olokevin/Infrared_Target/InfraredRayTarget/InfraredRayTarget/InfraredRayTarget/Images/smallArmor.png

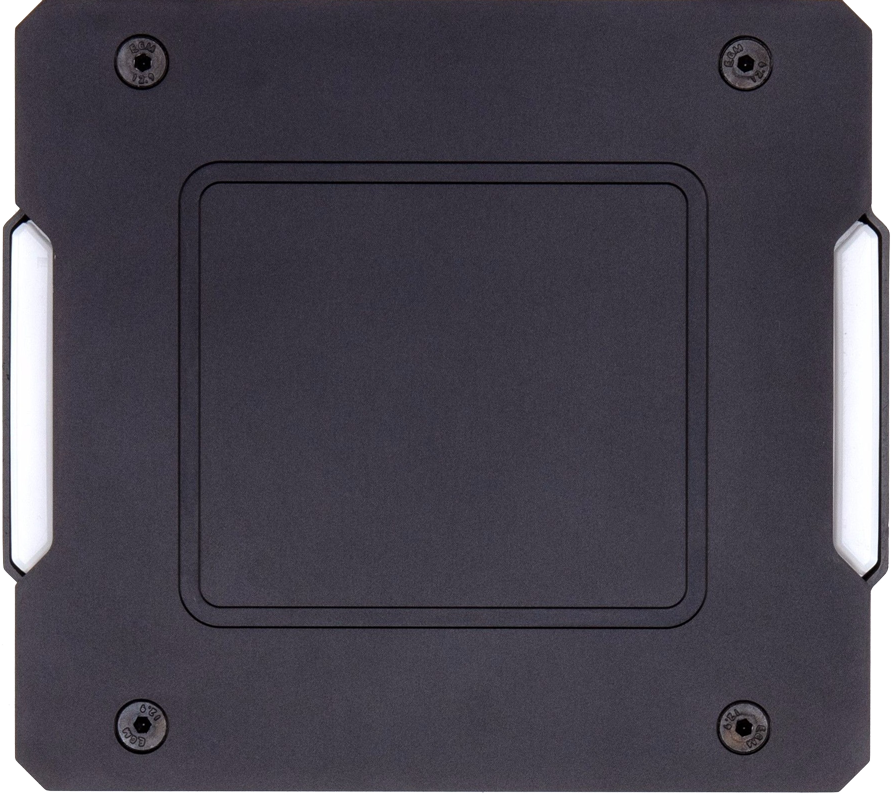
InfraredRayTarget/InfraredRayTarget/InfraredRayTarget/Images/smallArmor.png
