olokevin/Infrared_Target/InfraredRayTarget/InfraredRayTarget/InfraredRayTarget/bin/红外靶1.1/RM红外靶截图/123000.png

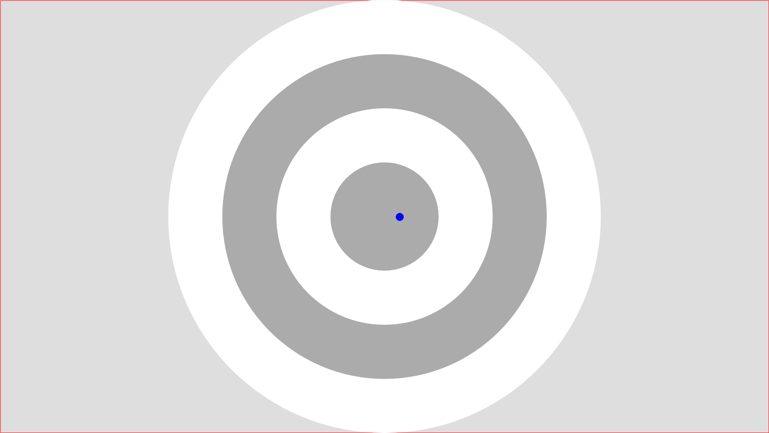
InfraredRayTarget/InfraredRayTarget/InfraredRayTarget/bin/红外靶1.1/RM红外靶截图/123000.png
