olokevin/Infrared_Target/InfraredRayTarget/InfraredRayTarget/InfraredRayTarget/bin/红外靶1.1/RM红外靶截图/player0 2019年09月12日 14时36分53秒.png

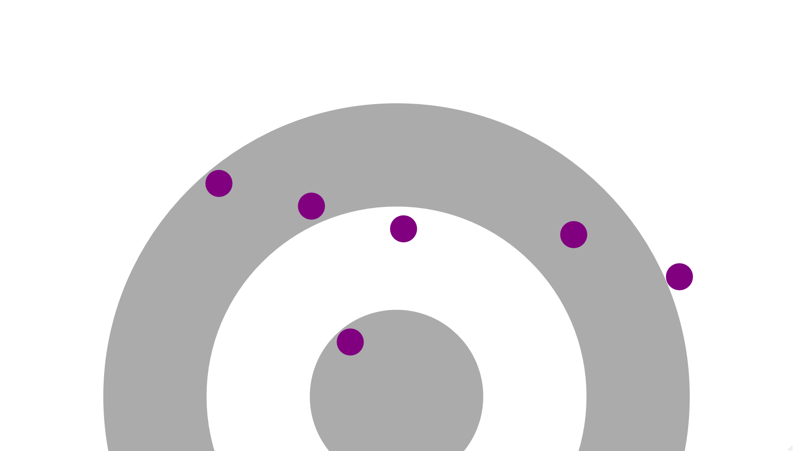
InfraredRayTarget/InfraredRayTarget/InfraredRayTarget/bin/红外靶1.1/RM红外靶截图/player0 2019年09月12日 14时36分53秒.png
