olokevin/Infrared_Target/InfraredRayTarget/InfraredRayTarget/InfraredRayTarget/bin/红外靶1.1/RM红外靶截图/player1弹道数据 2019年09月16日 15时26分09秒 2019年09月16日 15时35分35秒.png

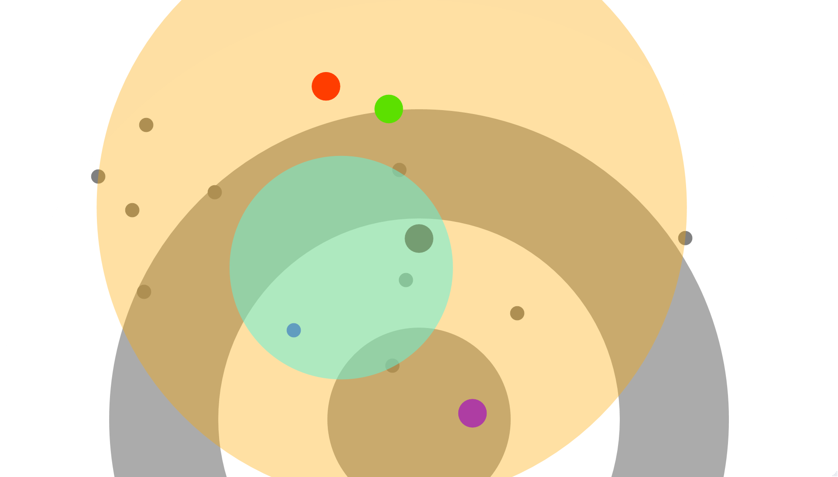
InfraredRayTarget/InfraredRayTarget/InfraredRayTarget/bin/红外靶1.1/RM红外靶截图/player1弹道数据 2019年09月16日 15时26分09秒 2019年09月16日 15时35分35秒.png
