olokevin/Infrared_Target/InfraredRayTarget/InfraredRayTarget/InfraredRayTarget/bin/红外靶1.1/RM红外靶截图/Temp 2019年09月27日 19时30分14秒.png

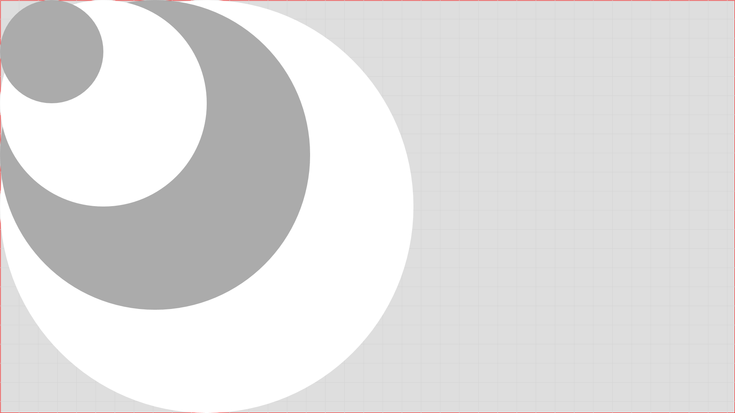
InfraredRayTarget/InfraredRayTarget/InfraredRayTarget/bin/红外靶1.1/RM红外靶截图/Temp 2019年09月27日 19时30分14秒.png
