olokevin/Infrared_Target/InfraredRayTarget/InfraredRayTarget/InfraredRayTarget/bin/红外靶1.1/RM红外靶截图/Temp弹道数据 2019年09月18日 16时16分26秒 2019年09月18日 16时19分42秒.png

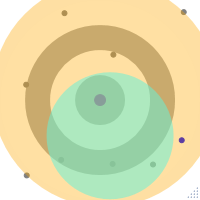
InfraredRayTarget/InfraredRayTarget/InfraredRayTarget/bin/红外靶1.1/RM红外靶截图/Temp弹道数据 2019年09月18日 16时16分26秒 2019年09月18日 16时19分42秒.png
