olokevin/Infrared_Target/InfraredRayTarget/InfraredRayTarget/InfraredRayTarget/bin/红外靶1.1/RM红外靶截图/Temp弹道数据 2019年11月07日 22时32分00秒 2019年11月07日 22时45分12秒.png

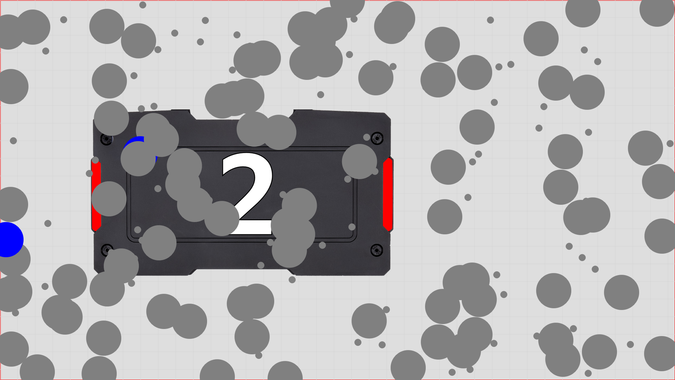
InfraredRayTarget/InfraredRayTarget/InfraredRayTarget/bin/红外靶1.1/RM红外靶截图/Temp弹道数据 2019年11月07日 22时32分00秒 2019年11月07日 22时45分12秒.png
