olokevin/Infrared_Target/InfraredRayTarget/InfraredRayTarget/InfraredRayTarget/Images/001x.png

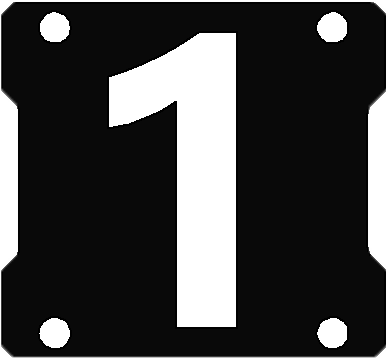
InfraredRayTarget/InfraredRayTarget/InfraredRayTarget/Images/001x.png
