olokevin/Infrared_Target/InfraredRayTarget/InfraredRayTarget/InfraredRayTarget/Images/002x.png

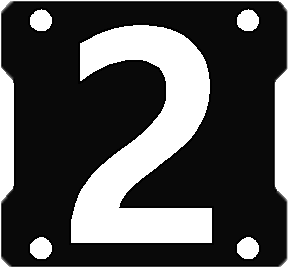
InfraredRayTarget/InfraredRayTarget/InfraredRayTarget/Images/002x.png
