olokevin/Infrared_Target/InfraredRayTarget/InfraredRayTarget/InfraredRayTarget/Images/bigArmor.png

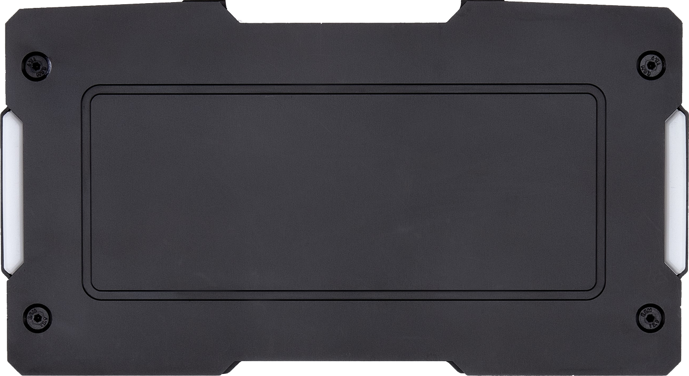
InfraredRayTarget/InfraredRayTarget/InfraredRayTarget/Images/bigArmor.png
