olokevin/Infrared_Target/InfraredRayTarget/InfraredRayTarget/InfraredRayTarget/Images/smal_armor.png

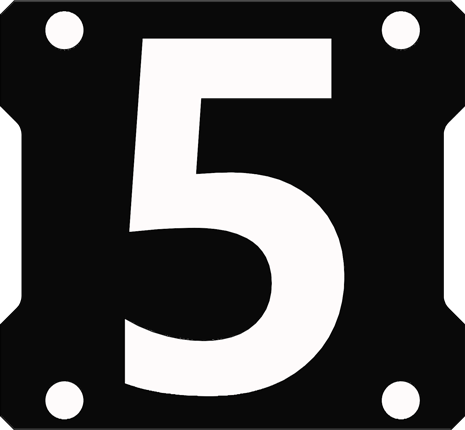
InfraredRayTarget/InfraredRayTarget/InfraredRayTarget/Images/smal_armor.png
