olokevin/Infrared_Target/InfraredRayTarget/InfraredRayTarget/InfraredRayTarget/Images/tempBlueArmor.png

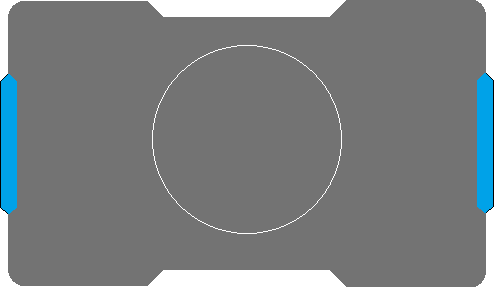
InfraredRayTarget/InfraredRayTarget/InfraredRayTarget/Images/tempBlueArmor.png
