olokevin/Infrared_Target/InfraredRayTarget/InfraredRayTarget/InfraredRayTarget/Images/tempRedArmor.png

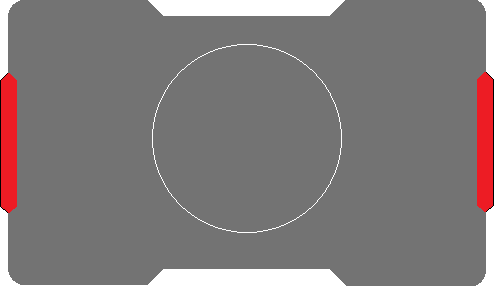
InfraredRayTarget/InfraredRayTarget/InfraredRayTarget/Images/tempRedArmor.png
