olokevin/Infrared_Target/红外靶工程图/红外靶开源资料/红外靶相关文档/红外靶说明简介.jpg

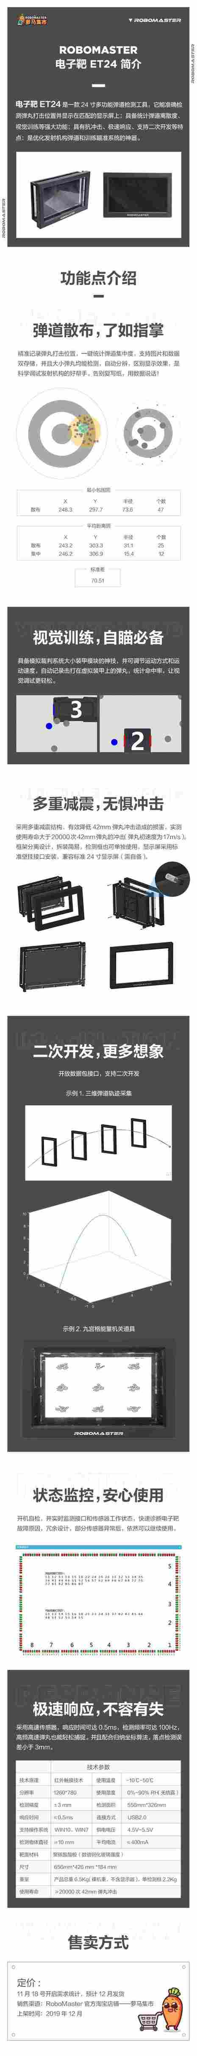
红外靶工程图/红外靶开源资料/红外靶相关文档/红外靶说明简介.jpg
