olokevin/Infrared_Target/红外靶工程图/红外靶开源资料/红外靶工程图及BOM清单/红外靶BOM表.xlsx

Sheet: 机械结构清单bom
序号 | 类别 | 名称 | 模块 | 料号 | 采购数量 | 单套数量 | 总数量 | 单价CNY | 单套总价 | 总价 | 库存 | 预计到货时间
 | 机加 | 钣金壳01 | 红外框 | banjinke01 | 2
 | 机加 | 钣金壳02 | 红外框 | banjinke02 | 1
 | 机加 | 钣金壳03 | 红外框 | banjinke03 | 1
 | 机加 | 铝架01 | 红外框 | 包含pipe 3/8 | 1
 | 机加 | 线材固定板 | 红外框 |  | 1
 | 机加 | 包装eva | 红外框 |  | 1
 | 五金 | m4*12 | 红外框 |  | 16
 | 五金 | m3*10 | 红外框 |  | 52
 | 五金 | m3*8 | 红外框 |  | 2
 | 五金 | M3*5.5凸台 | 红外框 |  | 8
 | 五金 | m3拉铆螺母 | 红外框 |  | 43
 | 五金 | m4拉铆螺母 | 红外框 |  | 12
 | 五金 | 铜柱m3*10+8 | 红外框 |  | 2
 | 五金 | 铜柱m3*20+8 | 红外框 |  | 32
 | 五金 | 螺纹胶（红） | 红外框 |  | 1
 | 五金 | 螺纹胶（蓝） | 红外框 |  | 1
 | 五金 | 铜套-15 | 铝架 |  | 4
 | 五金 | 管塞15*15 | 铝架 |  | 4
 | 机加 | 铝架02 | 铝架 | 包含pipe 1/2/4/5/6/7 | 1
 | 机加 | PC打击面板 | 铝架 | yc_jg_qx000508 | 1
 | 机加 | 显示器固定板 | 铝架 |  | 1
 | 五金 | m4*45 | 铝架 |  | 4
 | 五金 | m4*55 | 铝架 |  | 16
 | 五金 | m4防松螺母（黑） | 铝架 |  | 16
 | 五金 | m3防松螺母（黑） | 铝架 |  | 4
 | 五金 | m3*25 | 铝架 |  | 4
 | 五金 | 脚杯 | 铝架 |  | 2

Sheet: 电子元件清单
红外靶P1版硬件BOM
序号 | 类别 | 名称 | 型号/封装 | 料号 | 采购数量 | 单套数量 | 总数量 | 单价CNY | 单套总价 | 总价 | 库存 | 预计到货时间 | 备注
1 | 电容 | 18pF | 0201 |  |  | 2 | 120
2 |  | 1nF | 0201 |  |  | 1 | 60
3 |  | 100nF | 0201 |  |  | 60 | 3600
4 |  | 100nF | 0402 |  |  | 41 | 2460
5 |  | 1uF | 0402 |  |  | 43 | 2580
6 |  | 2.2uF | 0603 |  |  | 2 | 120
7 |  | 4.7uF | 0603 |  |  | 27 | 1620
8 |  | 10uF | 0805 |  |  | 26 | 1560
 | 电阻 | 0R | 0402 |  |  | 2 | 120
 |  | 22R | 0201 |  |  | 2 | 120
9 |  | 82.5R | 1210 |  |  | 52 | 3120
10 |  | 100R | 0201 |  |  | 4 | 240
11 |  | 510R | 0402 |  |  | 2 | 120
12 |  | 510R | 0201 |  |  | 104 | 6240
13 |  | 1KR | 0201 |  |  | 130 | 7800
14 |  | 1.5KR | 0201 |  |  | 1 | 60
 |  | 2.2KR | 0201 |  |  | 104 | 6240
15 |  | 10KR | 0201 |  |  | 106 | 6360
16 |  | 1MR | 0201 |  |  | 1 | 60
17 | 二极管 &LED | BL-HGEUB34H-TRB | LED |  |  | 1 | 60
18 |  | TPD1E10B06DP | ESD |  |  | 1 | 60
19 |  | PESD5V0F1BL | ESD |  |  | 142 | 8520
20 |  | SFH203FA |  |  | 7000 | 104 | 6240
21 |  | SFH4545 |  |  | 7000 | 104 | 6240
22 | 磁珠 | BLM15BB121SN1 | 0402 |  |  | 2 | 120
23 |  | BLM18PG221SN1 | 0603 |  |  | 1 | 60
 | 晶振 | SX32Y012000DI1T | 3225 |  |  | 1 | 60
25 | IC | STM32F303CBT6 | LQFP48 |  |  | 1 | 60
26 |  | LP5907MFX-3.3/NOPB | SOT-23-5 |  |  | 1 | 60
27 |  | 74HC164PW | TSSOP-14 |  |  | 26 | 1560
28 |  | 74CBTLV3126BQ | DHVQFN14 |  |  | 26 | 1560
29 | 三极管 | MMSS8050-H | SOT-23 |  |  | 104 | 6240
30 |  | PMBT3904,215 | SOT-23 |  |  | 104 | 6240
31 | 连接器 | OK-F501-08325 | 8P |  |  | 28 | 1680
32 |  | 503480-1000 | 10P |  |  | 28 | 1680
33 |  | 105017-0001 | USB |  |  | 1 | 60
34 | 线材 | FPC线0.5-8P-800A | 导电布 |  | 100 | 1 | 60
 |  | FPC线0.5-10P-500A | 导电布 |  | 100 | 1 | 60
 |  | FPC线0.5-8P-27A | 黑膜 |  | 1000 | 12 | 720
 |  | FPC线0.5-10P-27A | 黑膜 |  | 1000 | 12 | 720
35 |  | USB线 | 3M |  |  | 1 | 60
 |  |  |  |  |  |  |  | 总计 | 0 | 0
