olokevin/Infrared_Target/InfraredRayTarget/InfraredRayTarget/InfraredRayTarget/bin/Debug/RM红外靶弹道记录/111.csv

模式 | 序号 | 弹型 | X(像素) | Y(像素) | 其他 | 时间
靶子模式 | 1 | 小弹丸 | 434 | 526 | 4/1环 | 2019-11-07 22:46:29:378
靶子模式 | 2 | 小弹丸 | 1390 | 281 | 4/1环 | 2019-11-07 22:46:29:529
靶子模式 | 3 | 大弹丸 | 320 | 17 | 出界 | 2019-11-07 22:46:29:786
靶子模式 | 4 | 大弹丸 | 903 | 749 | 4/3环 | 2019-11-07 22:46:29:922
靶子模式 | 5 | 小弹丸 | 147 | 52 | 出界 | 2019-11-07 22:46:30:161
靶子模式 | 6 | 小弹丸 | 1646 | 467 | 出界 | 2019-11-07 22:46:30:297
靶子模式 | 7 | 大弹丸 | 1847 | 605 | 出界 | 2019-11-07 22:46:30:697
靶子模式 | 8 | 大弹丸 | 509 | 256 | 4/1环 | 2019-11-07 22:46:30:825
