olokevin/Infrared_Target/红外靶工程图/红外靶开源资料/红外靶工程图及BOM清单/红外靶整机三视图.pdf

1 | 2 | 3 | 4 | 5 | 6

A

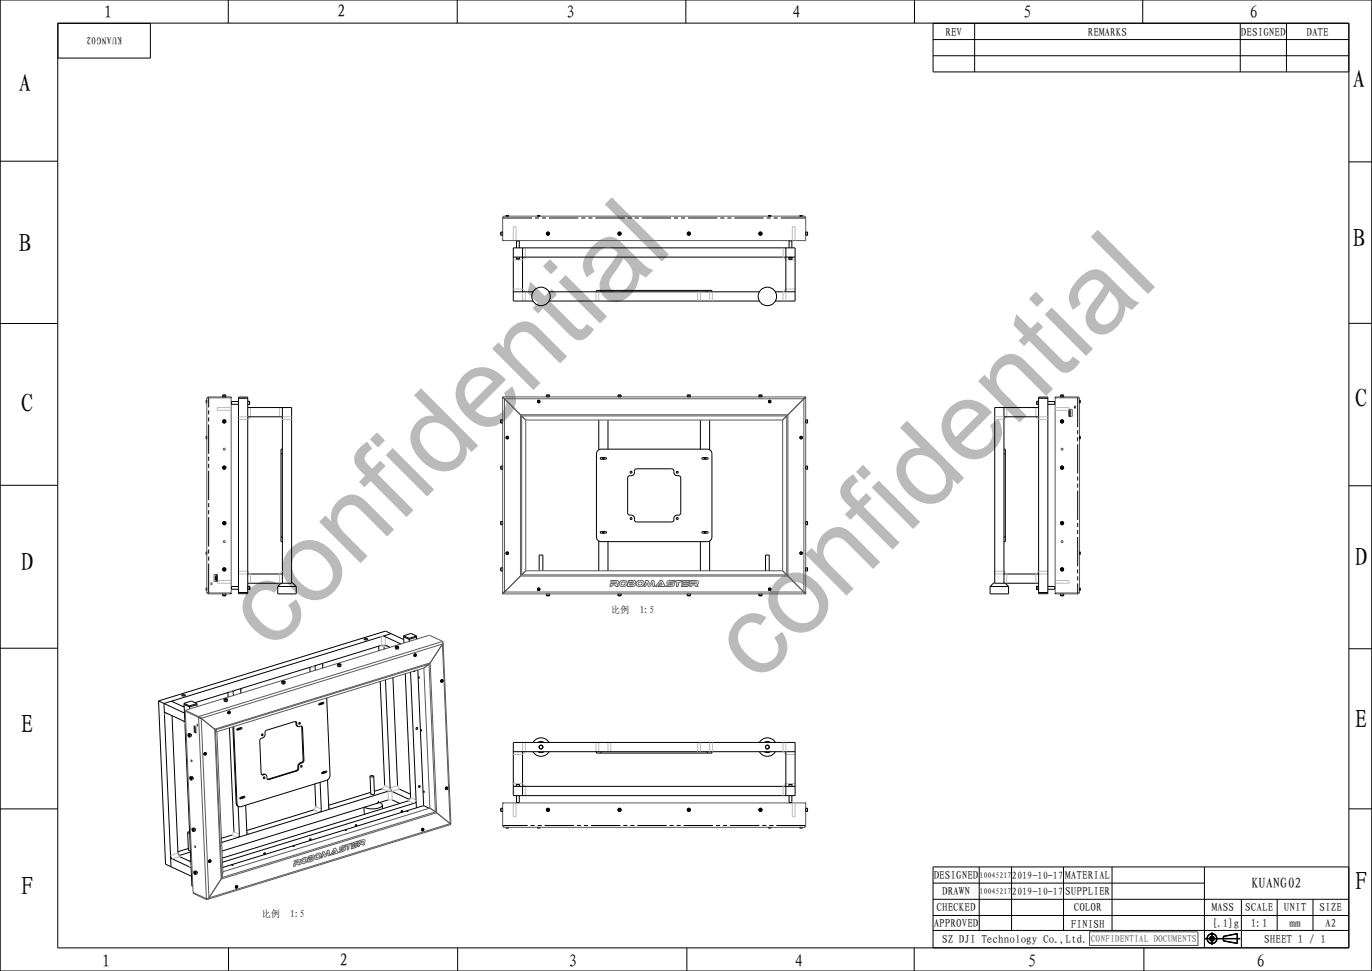
[picture p33: page 1]
confidential confidential; REV; REMARKS; DESIGNED; DATE

DESIGNED100452172019-10-17 MATERIAL | 100452172019-10-17 SUPPLIER | | KUANG02 DRAWN

CHECKED | | COLOR | MASS | SCALE | UNIT | SIZE
APPROVED | | FINISH | [.1]g | 1:1 | mm | A2
SZ DJI Technology Co.,Ltd. | CONFIDENTIAL DOCUMENTS | | | SHEET 1 / 1
