olokevin/Infrared_Target/红外靶工程图/红外靶开源资料/红外靶工程图及BOM清单/电路板2d图/bc_rm_pp000223.pdf

1 | 2 | 3 | 4 | 5 | 6

A

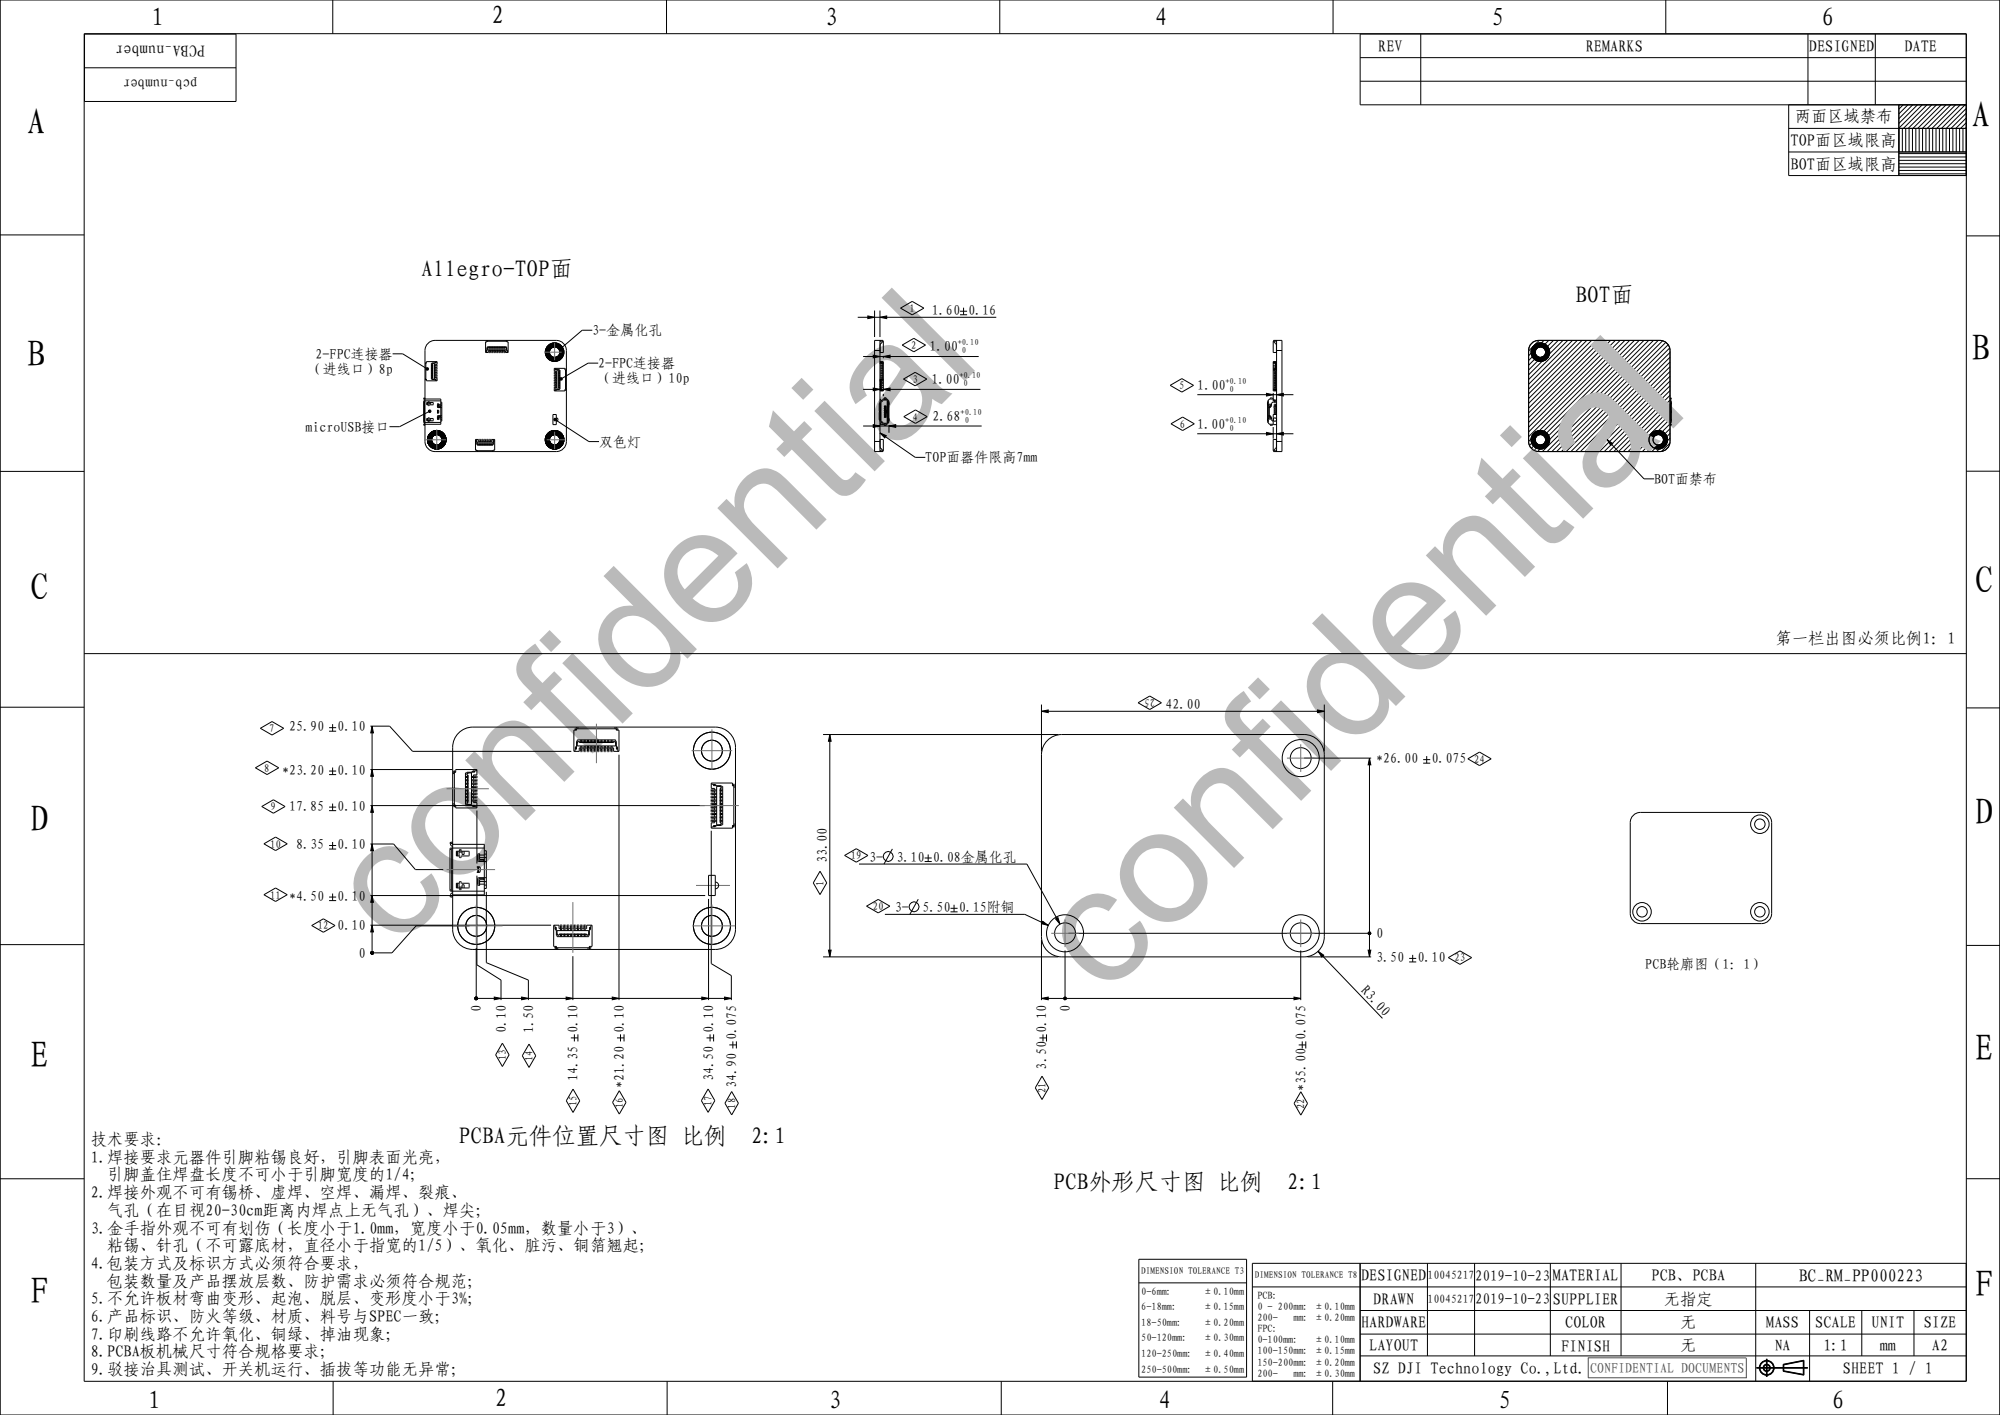
[picture p35: page 1]
第一栏出图必须比例1：1; confidential confidential; 0.08金属化孔; DIMENSION TOLERANCE T3; REV; REMARKS; DESIGNED; DATE; 两面区域禁布 TOP面区域限高 BOT面区域限高; Allegro-TOP面; BOT面; PCB轮廓图（1：1）; PCBA元件位置尺寸图 比例 2:1; 2-FPC连接器 （进线口）10p; 2-FPC连接器 （进线口）8p; 双色灯; microUSB接口; 3-金属化孔; TOP面器件限高7mm; BOT面禁布; PCB外形尺寸图 比例 2:1

技术要求：
1.焊接要求元器件引脚粘锡良好，引脚表面光亮，
引脚盖住焊盘长度不可小于引脚宽度的1/4；
2.焊接外观不可有锡桥、虚焊、空焊、漏焊、裂痕、
气孔（在目视20-30cm距离内焊点上无气孔）、焊尖；
3.金手指外观不可有划伤（长度小于1.0mm，宽度小于0.05mm，数量小于3）、
粘锡、针孔（不可露底材，直径小于指宽的1/5）、氧化、脏污、铜箔翘起；
4.包装方式及标识方式必须符合要求，

DIMENSION TOLERANCE T8 | DESIGNED100452172019-10-23 MATERIAL | | | | PCB、PCBA | BC_RM_PP000223
PCB: 0 - 200mm: ±0.10mm 200-mm: ±0.20mm FPC: 0-100mm: ±0.10mm 100-150mm: ±0.15mm 150-200mm: ±0.20mm 200-mm: ±0.30mm | DRAWN | 100452172019-10-23 SUPPLIER | | | 无指定

包装数量及产品摆放层数、防护需求必须符合规范；
5.不允许板材弯曲变形、起泡、脱层、变形度小于3%；
6.产品标识、防火等级、材质、料号与SPEC一致；
7.印刷线路不允许氧化、铜绿、掉油现象；
8.PCBA板机械尺寸符合规格要求；
9.驳接治具测试、开关机运行、插拔等功能无异常；

HARDWARE | | | COLOR | 无 | MASS | SCALE | UNIT | SIZE
LAYOUT | | | FINISH | 无 | NA | 1:1 | mm | A2
SZ DJI Technology Co.,Ltd. | CONFIDENTIAL DOCUMENTS | | | | | SHEET 1 / 1
