olokevin/Infrared_Target/红外靶工程图/红外靶开源资料/红外靶工程图及BOM清单/电路板2d图/bc_rm_pp000224.pdf

1 | 2 | 3 | 4 | 5 | 6

A

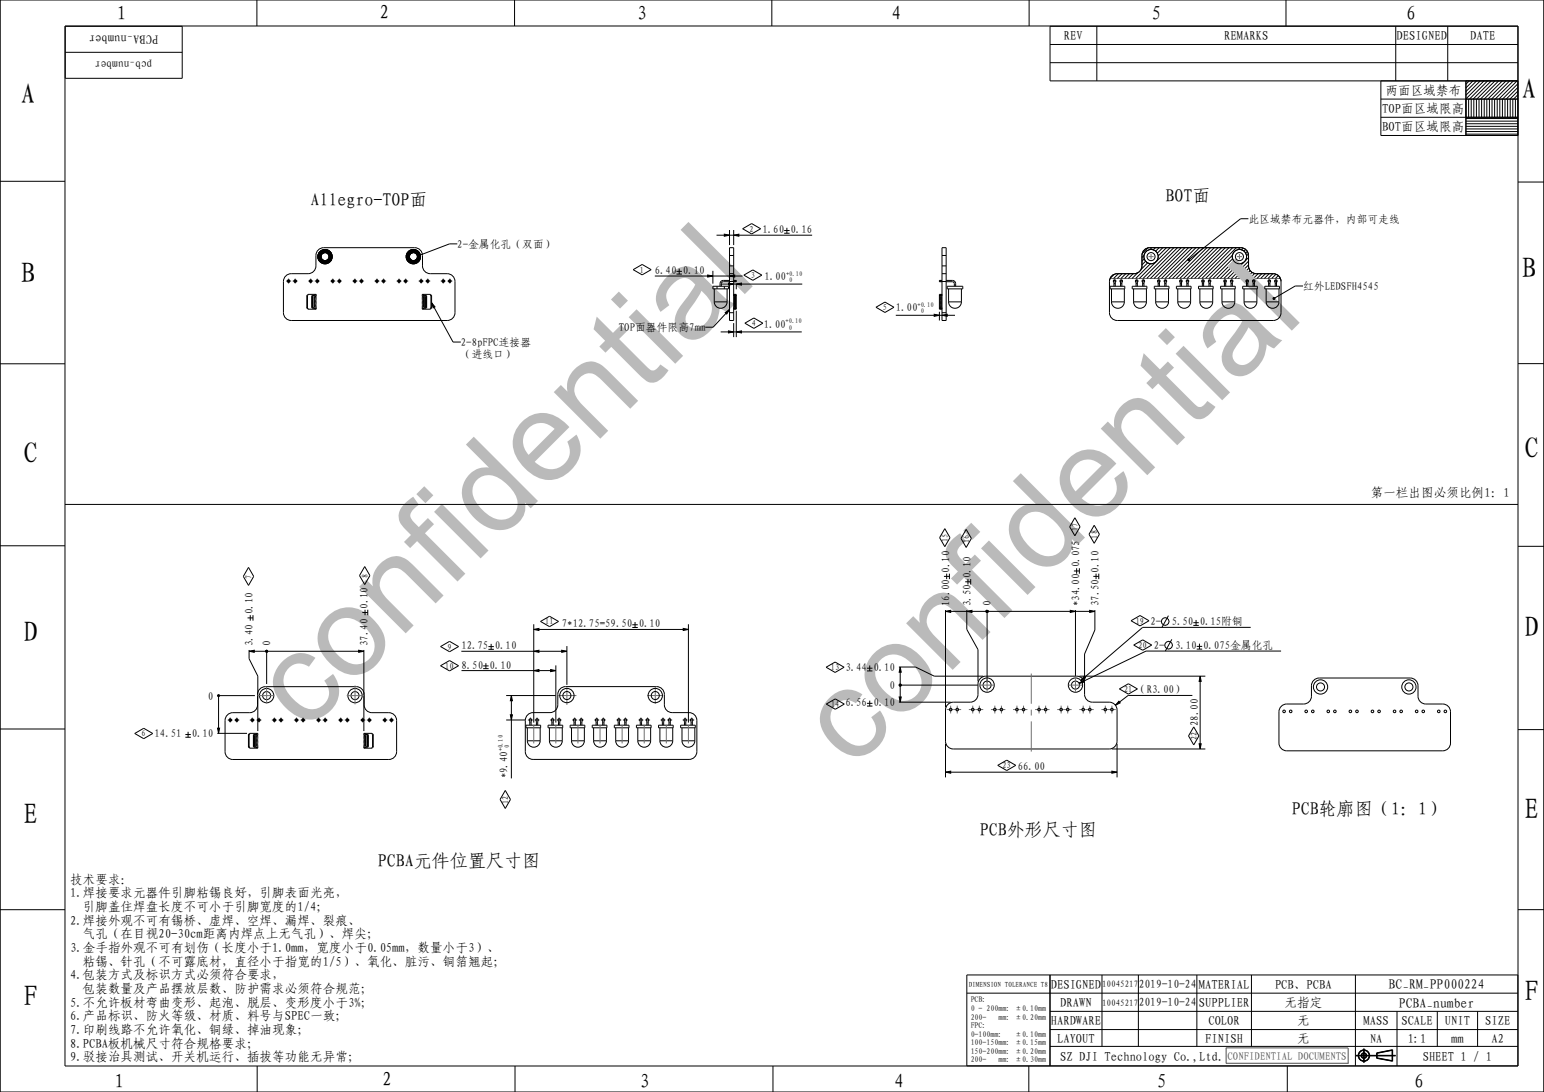
[picture p36: page 1]
第一栏出图必须比例1：1; confidential confidential; 0.075金属化孔; REV; REMARKS; DESIGNED; DATE; 两面区域禁布 TOP面区域限高 BOT面区域限高; Allegro-TOP面; 2-金属化孔（双面）; 2-8pFPC连接器 （进线口）; TOP面器件限高7mm; PCBA元件位置尺寸图; PCB外形尺寸图; PCB轮廓图（1：1）; 红外LEDSFH4545; 此区域禁布元器件，内部可走线; BOT面

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

DIMENSION TOLERANCE T8 | DESIGNED100452172019-10-24 MATERIAL | | | | PCB、PCBA | BC_RM_PP000224
PCB: 0 - 200mm: ±0.10mm 200-mm: ±0.20mm FPC: 0-100mm: ±0.10mm 100-150mm: ±0.15mm 150-200mm: ±0.20mm 200-mm: ±0.30mm | DRAWN | 100452172019-10-24 SUPPLIER | | | 无指定 | PCBA_number

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
