olokevin/Infrared_Target/红外靶工程图/红外靶开源资料/红外靶工程图及BOM清单/电路板2d图/dengban.pdf

A

A

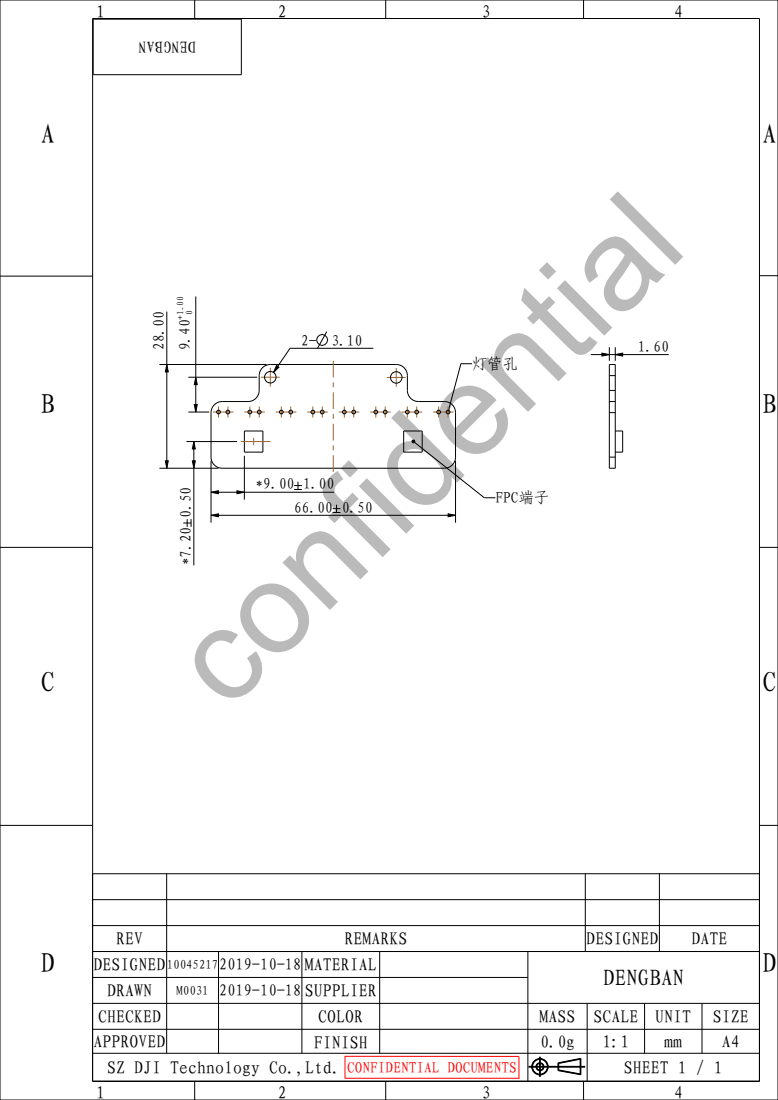
[picture p38: page 1]
CONFIDENTIAL DOCUMENTS; confidential; 灯管孔; FPC端子

REV | REMARKS | DESIGNED | DATE
DESIGNED100452172019-10-18 MATERIAL | M0031 | 2019-10-18 SUPPLIER | | DENGBAN DRAWN

CHECKED | | | COLOR | MASS | SCALE | UNIT | SIZE
APPROVED | | | FINISH | 0.0g | 1:1 | mm | A4
SZ DJI Technology Co.,Ltd. | | | | | | SHEET 1 / 1
