olokevin/Infrared_Target/红外靶工程图/红外靶开源资料/红外靶工程图及BOM清单/电路板2d图/zhukong.pdf

A

A

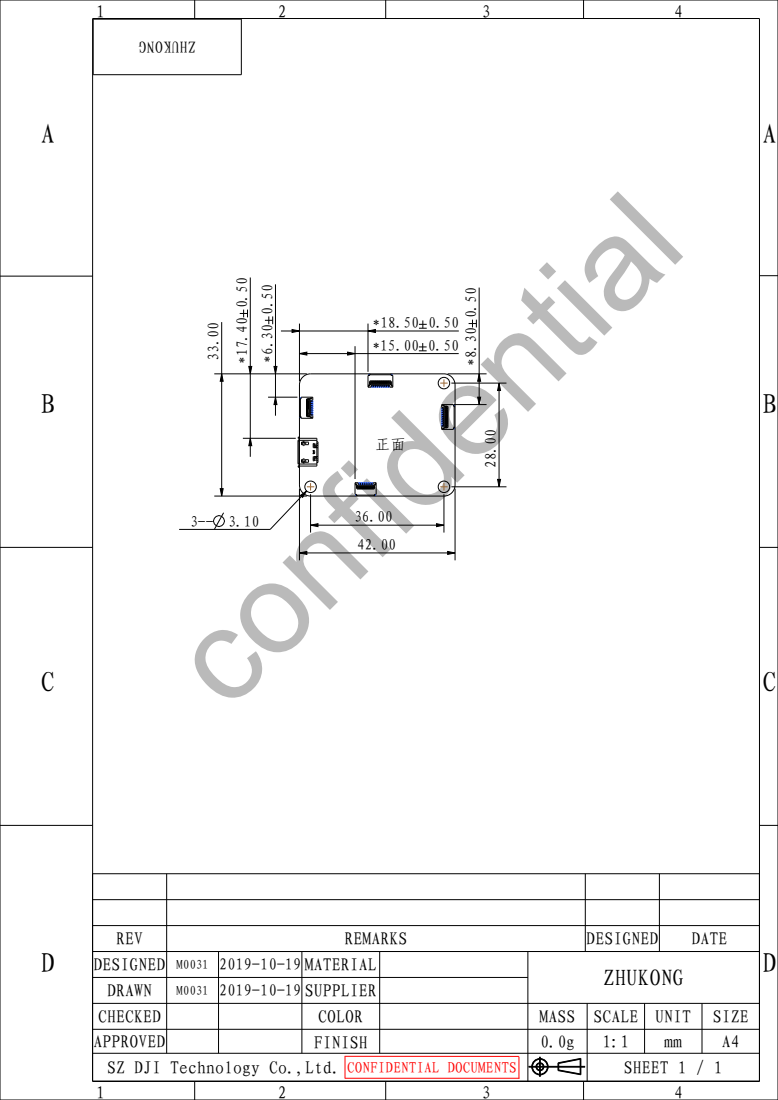
[picture p39: page 1]
CONFIDENTIAL DOCUMENTS; confidential *6.30 0.50 *8.30 0.50

REV | REMARKS | DESIGNED | DATE
DESIGNED | M0031 | 2019-10-19 MATERIAL 2019-10-19 SUPPLIER | | ZHUKONG DRAWN

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
