olokevin/Infrared_Target/红外靶工程图/红外靶开源资料/红外靶工程图及BOM清单/机加类/PC打击面板.pdf

A

A

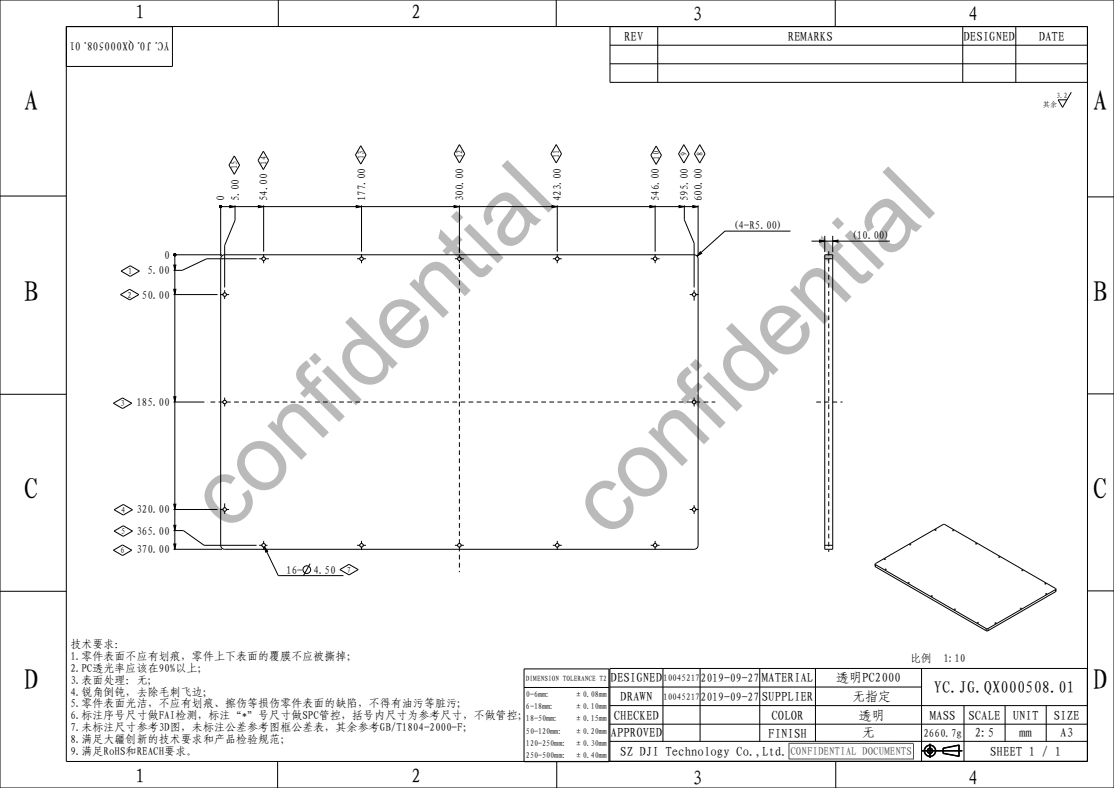
[picture p40: page 1]
confidential confidential; REV; REMARKS; DESIGNED; DATE; 技术要求： 1.零件表面不应有划痕，零件上下表面的覆膜不应被撕掉； 2.PC透光率应该在90%以上；

3.表面处理：无;
4.锐角倒钝，去除毛刺飞边;
5.零件表面光洁，不应有划痕、擦伤等损伤零件表面的缺陷，不得有油污等脏污;
6.标注序号尺寸做FAI检测，标注“*”号尺寸做SPC管控，括号内尺寸为参考尺寸，不做管控；
7.未标注尺寸参考3D图，未标注公差参考图框公差表，其余参考GB/T1804-2000-F；
8.满足大疆创新的技术要求和产品检验规范；
9.满足RoHS和REACH要求。

DIMENSION TOLERANCE T2 | DESIGNED100452172019-09-27 MATERIAL | 100452172019-09-27 SUPPLIER | 透明PC2000 无指定 | YC.JG.QX000508.01 DRAWN

CHECKED | | COLOR | 透明 | MASS | SCALE | UNIT | SIZE
APPROVED | | FINISH | 无 | 2660.7g | 2:5 | mm | A3
SZ DJI Technology Co.,Ltd. | CONFIDENTIAL DOCUMENTS | | | | | SHEET 1 / 1
