olokevin/Infrared_Target/红外靶工程图/红外靶开源资料/红外靶工程图及BOM清单/机加类/线材固定板.pdf

A

A

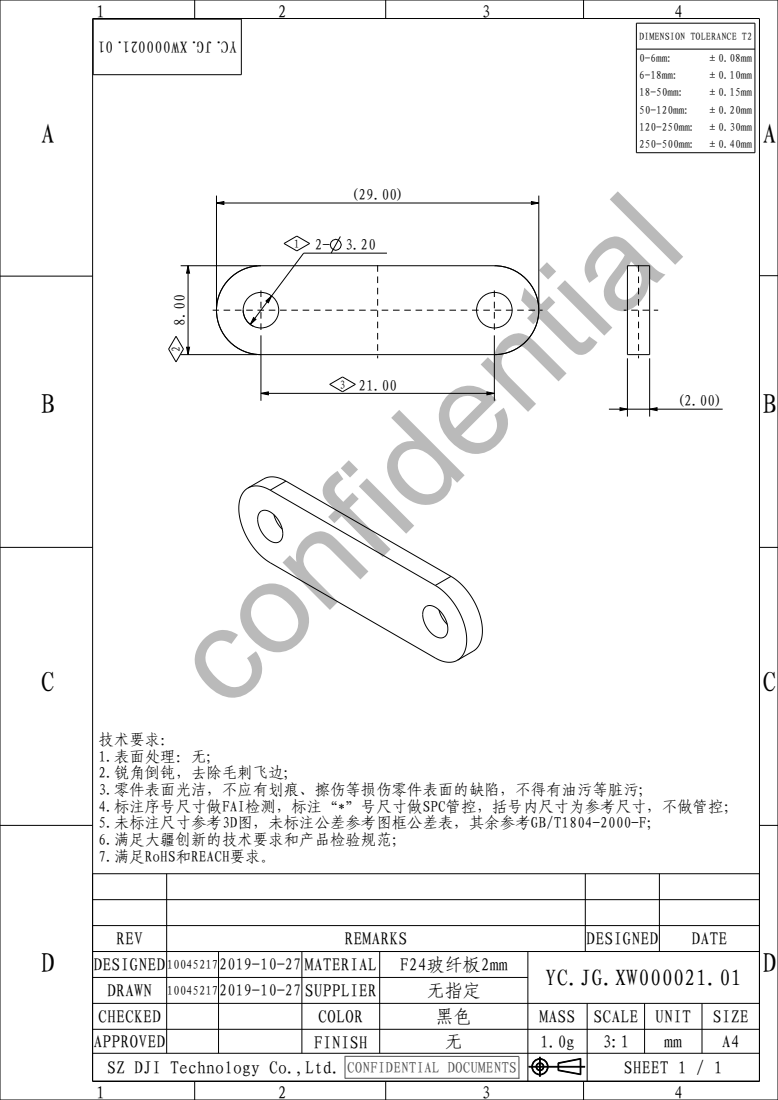
[picture p41: page 1]
CONFIDENTIAL DOCUMENTS; confidential; DIMENSION TOLERANCE T2

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

REV | REMARKS | DESIGNED | DATE
DESIGNED100452172019-10-27 MATERIAL | 100452172019-10-27 SUPPLIER | | | F24玻纤板2mm 无指定 | YC.JG.XW000021.01 DRAWN

CHECKED | | | COLOR | 黑色 | MASS | SCALE | UNIT | SIZE
APPROVED | | | FINISH | 无 | 1.0g | 3:1 | mm | A4
SZ DJI Technology Co.,Ltd. | | | | | | | SHEET 1 / 1
