olokevin/Infrared_Target/红外靶工程图/红外靶开源资料/红外靶工程图及BOM清单/钣金类/钣金壳03.pdf

A

A

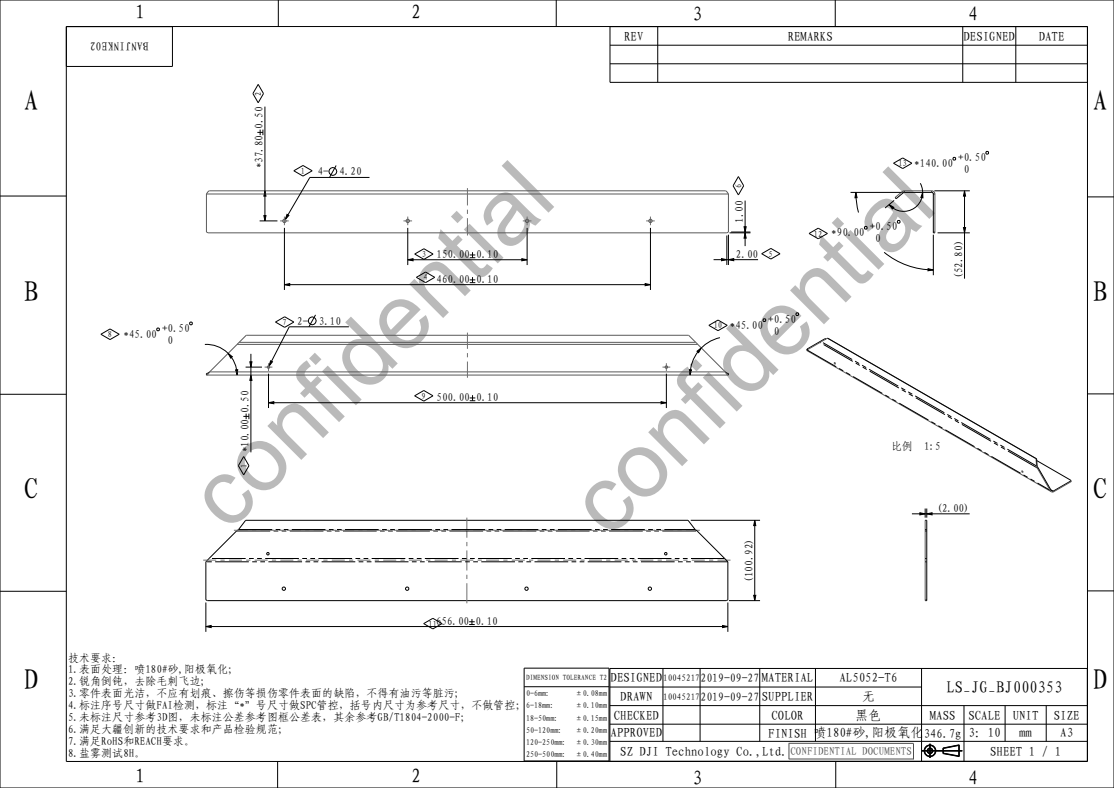
[picture p44: page 1]
confidential confidential; REV; REMARKS; DESIGNED; DATE; 技术要求： 1.表面处理：喷180#砂,阳极氧化;

2.锐角倒钝，去除毛刺飞边;
3.零件表面光洁，不应有划痕、擦伤等损伤零件表面的缺陷，不得有油污等脏污;
4.标注序号尺寸做FAI检测，标注“*”号尺寸做SPC管控，括号内尺寸为参考尺寸，不做管控；
5.未标注尺寸参考3D图，未标注公差参考图框公差表，其余参考GB/T1804-2000-F；
6.满足大疆创新的技术要求和产品检验规范；
7.满足RoHS和REACH要求。
8.盐雾测试8H。

DIMENSION TOLERANCE T2 | DESIGNED100452172019-09-27 MATERIAL | 100452172019-09-27 SUPPLIER | AL5052-T6 无 | LS_JG_BJ000353 DRAWN

CHECKED | | COLOR | 黑色 | MASS | SCALE | UNIT | SIZE
APPROVED | | FINISH 喷180#砂,阳极氧化346.7g | | | 3：10 | mm | A3
SZ DJI Technology Co.,Ltd. | CONFIDENTIAL DOCUMENTS | | | | | SHEET 1 / 1
