olokevin/Infrared_Target/红外靶工程图/红外靶开源资料/红外靶工程图及BOM清单/铝架/alu_pipe_2.pdf

A

A

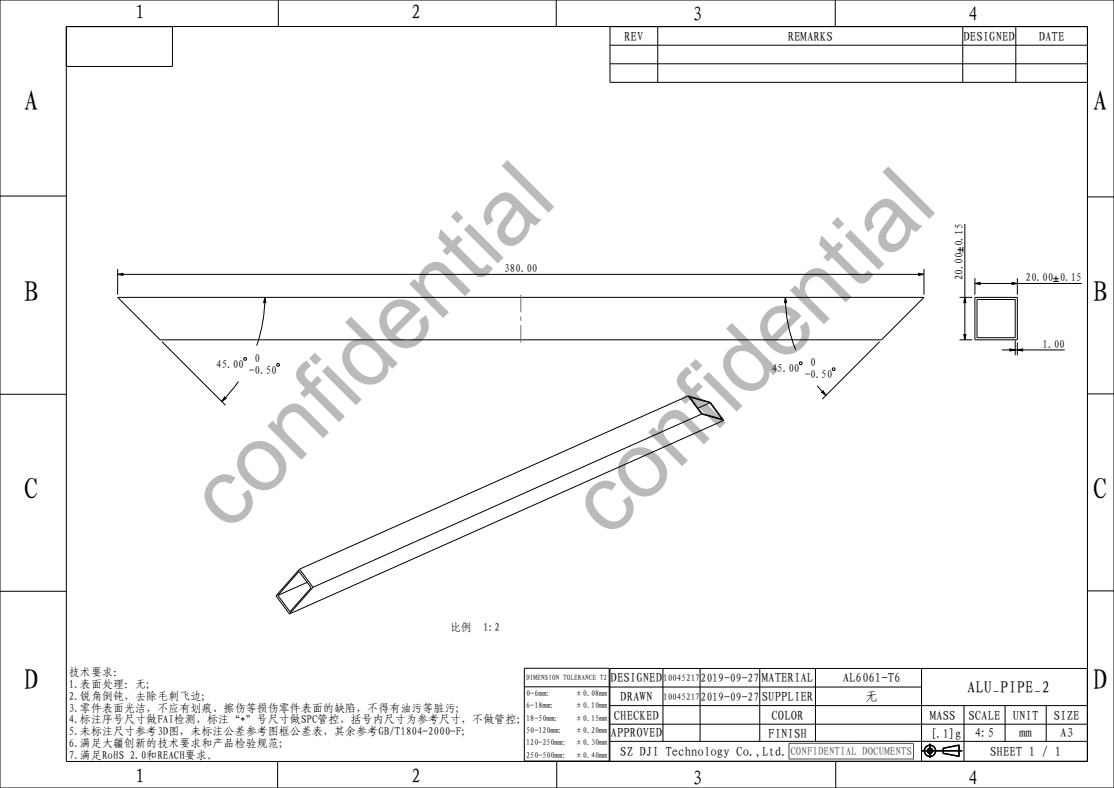
[picture p46: page 1]
confidential confidential; REV; REMARKS; DESIGNED; DATE

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

DIMENSION TOLERANCE T2 | DESIGNED100452172019-09-27 MATERIAL | 100452172019-09-27 SUPPLIER | AL6061-T6 无 | ALU_PIPE_2 DRAWN

CHECKED | | COLOR | MASS | SCALE | UNIT | SIZE
APPROVED | | FINISH | [.1]g | 4:5 | mm | A3
SZ DJI Technology Co.,Ltd. | CONFIDENTIAL DOCUMENTS | | | | SHEET 1 / 1
