olokevin/Infrared_Target/红外靶工程图/红外靶开源资料/红外靶工程图及BOM清单/铝架/alu_pipe_3.pdf

A

A

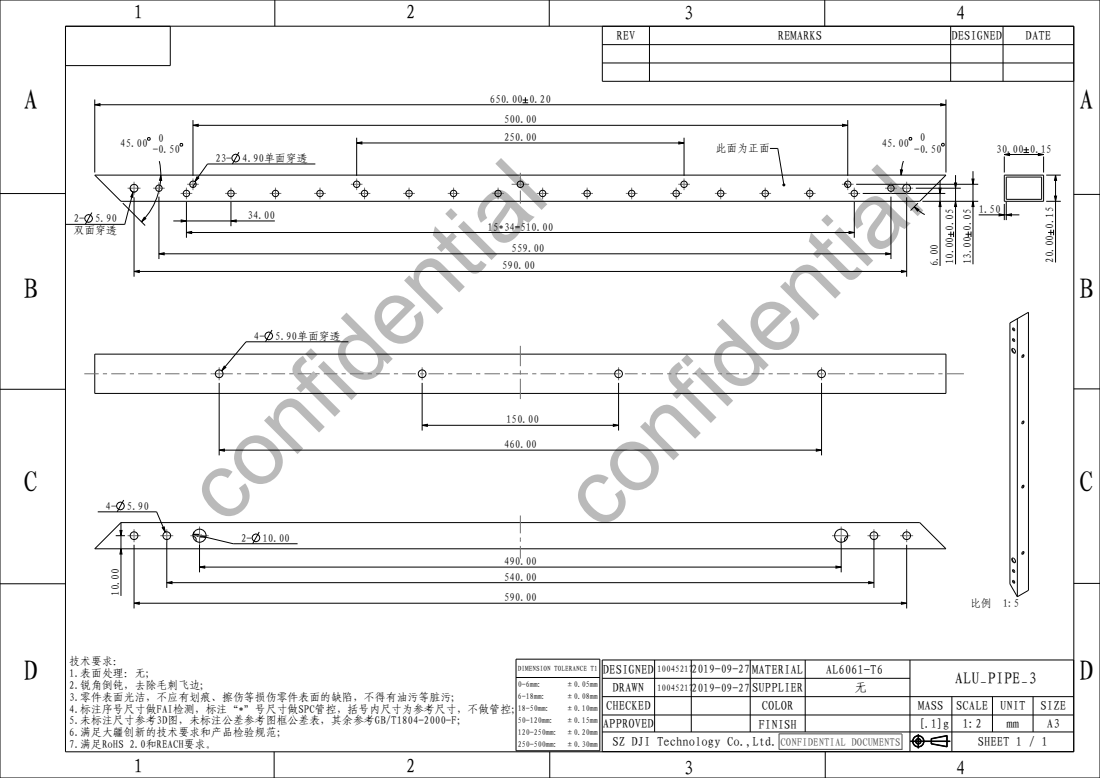
[picture p47: page 1]
confidential confidential; 4- 5.90单面穿透; 2- 5.90 双面穿透; 23- 4.90单面穿透; REV; REMARKS; DESIGNED; DATE; DESIGNED 100452172019-09-27 MATERIAL; ALU_PIPE_3 DRAWN; 100452172019-09-27 SUPPLIER; DIMENSION TOLERANCE T1; 技术要求：; 此面为正面

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

CHECKED | | COLOR | MASS | SCALE | UNIT | SIZE
APPROVED | | FINISH | [.1]g | 1:2 | mm | A3
SZ DJI Technology Co.,Ltd. | CONFIDENTIAL DOCUMENTS | | | | SHEET 1 / 1
