olokevin/Infrared_Target/红外靶工程图/红外靶开源资料/红外靶工程图及BOM清单/铝架/alu_pipe_4.pdf

A

A

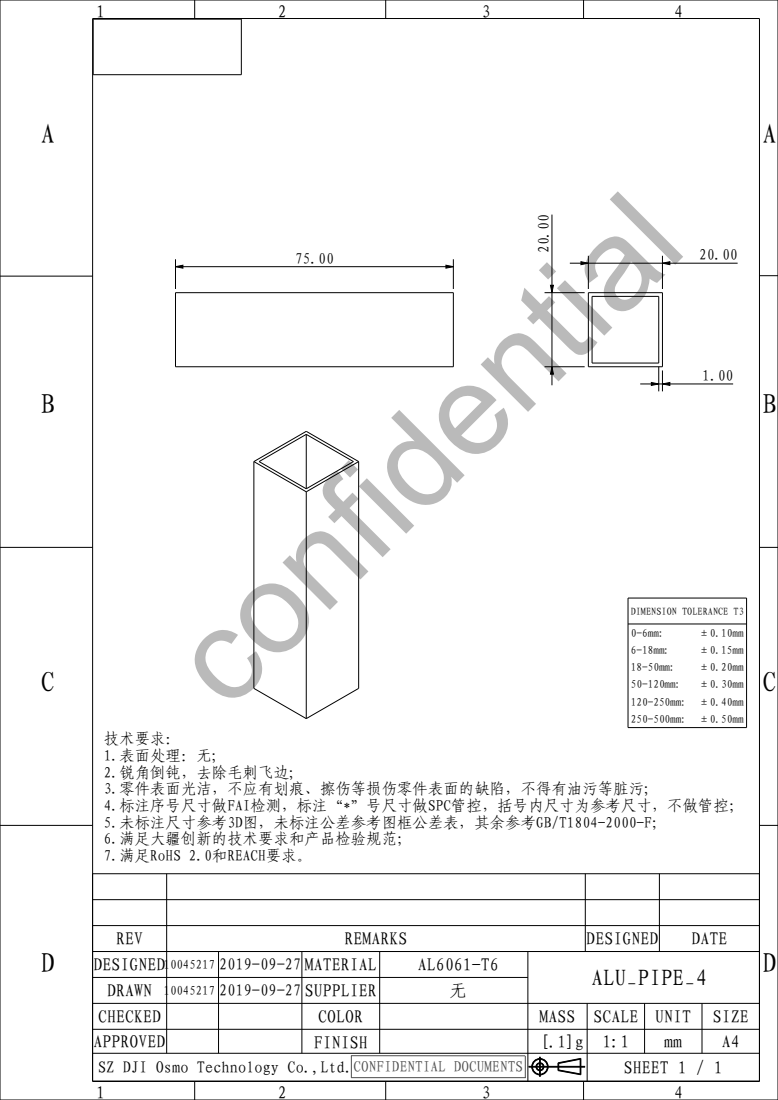
[picture p48: page 1]
confidential; DIMENSION TOLERANCE T3

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

REV | REMARKS | DESIGNED | DATE
DESIGNED10045217 | | 2019-09-27 MATERIAL 2019-09-27 SUPPLIER | | AL6061-T6 无 | ALU_PIPE_4 DRAWN 10045217

CHECKED | | | COLOR | | MASS | SCALE | UNIT | SIZE
APPROVED | | | FINISH | | [.1]g | 1:1 | mm | A4
SZ DJI Osmo Technology Co.,Ltd. | CONFIDENTIAL DOCUMENTS | | | | | SHEET 1 / 1
