olokevin/Infrared_Target/红外靶工程图/红外靶开源资料/红外靶工程图及BOM清单/铝架/alu_pipe_5.pdf

A

A

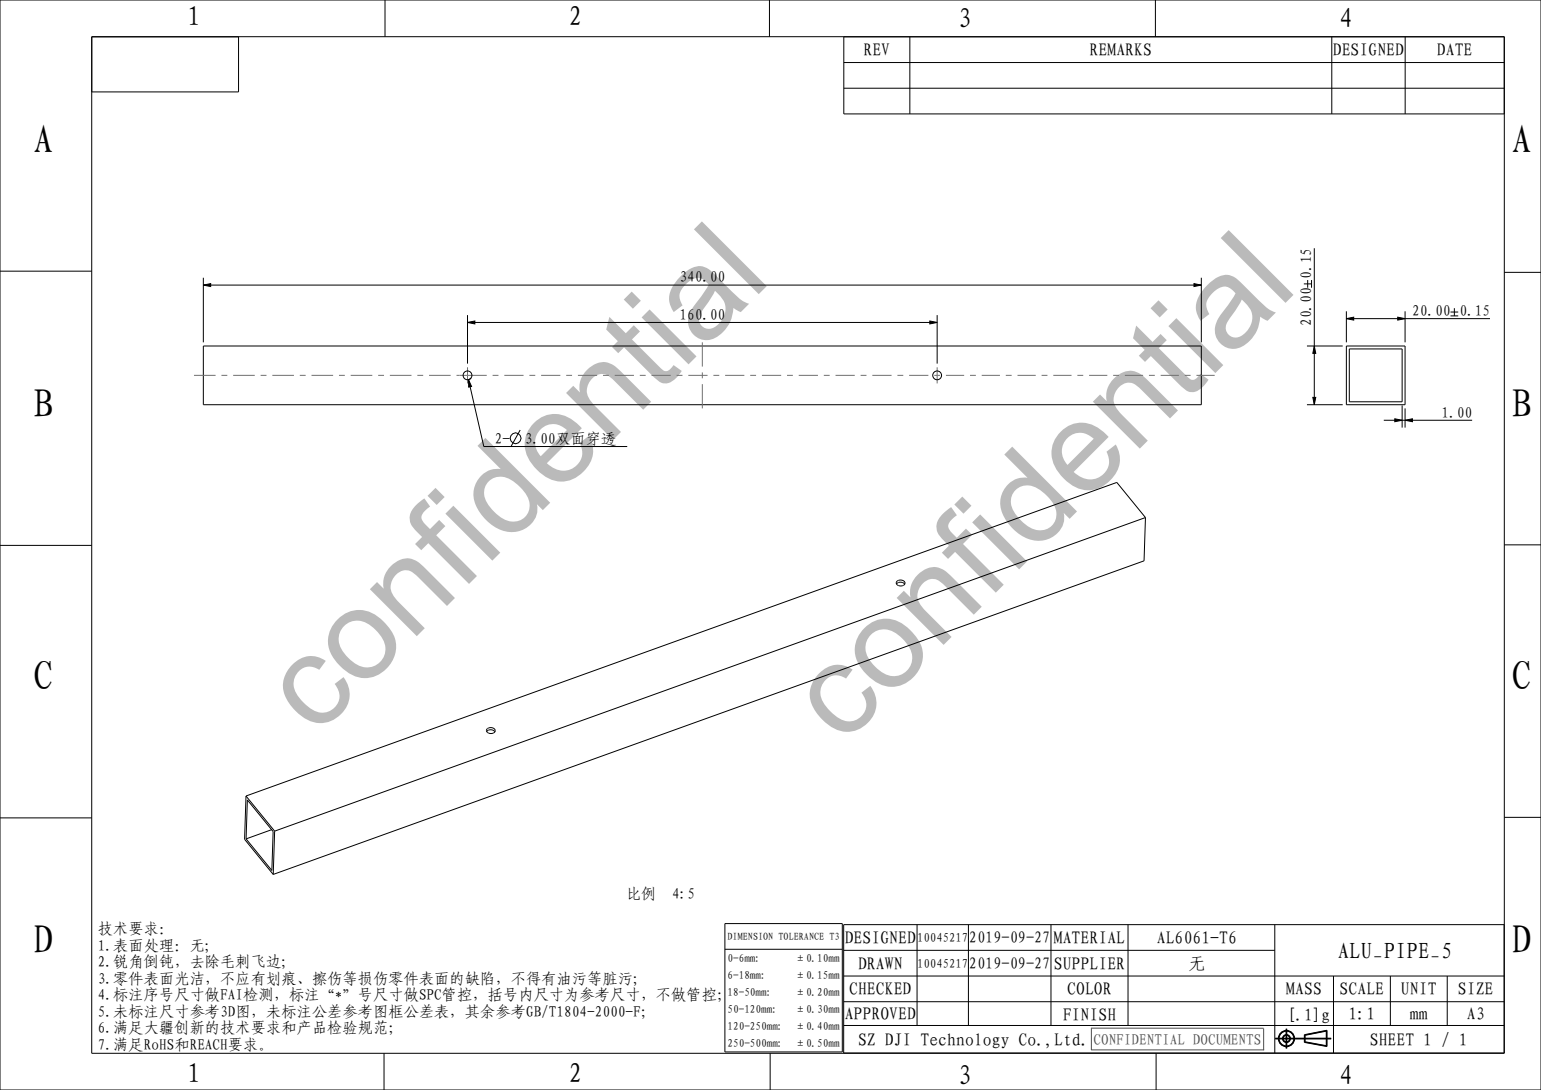
[picture p49: page 1]
confidential confidential; 2- 3.00双面穿透; REV; REMARKS; DESIGNED; DATE; DESIGNED100452172019-09-27 MATERIAL; ALU_PIPE_5 DRAWN; 100452172019-09-27 SUPPLIER; DIMENSION TOLERANCE T3

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
