olokevin/Infrared_Target/红外靶工程图/红外靶开源资料/红外靶工程图及BOM清单/铝架/铝架01.pdf

A

A

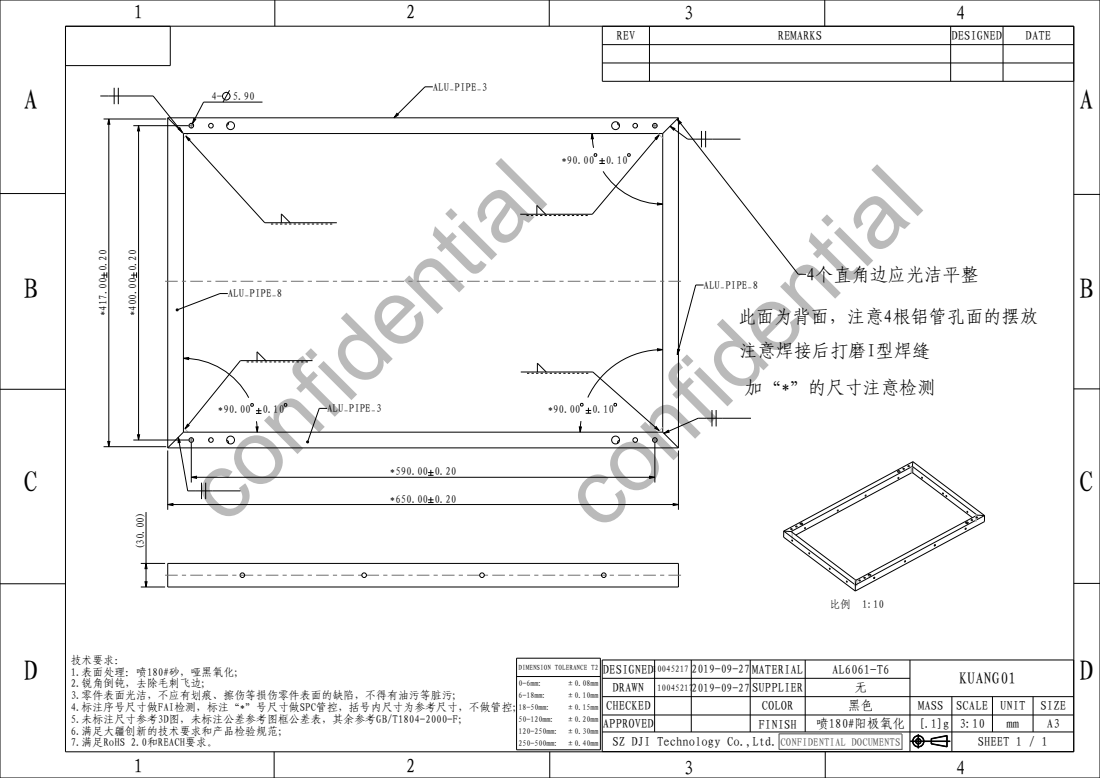
[picture p50: page 1]
confidential confidential; REV; REMARKS; DESIGNED; DATE; DESIGNED10045217; 2019-09-27 MATERIAL; KUANG01 DRAWN; 100452172019-09-27 SUPPLIER; DIMENSION TOLERANCE T2; 技术要求：; 加“*”的尺寸注意检测; 注意焊接后打磨I型焊缝; ALU_PIPE_8; ALU_PIPE_3; 此面为背面，注意4根铝管孔面的摆放; 4个直角边应光洁平整

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

CHECKED | | COLOR | 黑色 | MASS | SCALE | UNIT | SIZE
APPROVED | | FINISH | 喷180#阳极氧化 | [.1]g | 3:10 | mm | A3
SZ DJI Technology Co.,Ltd. | CONFIDENTIAL DOCUMENTS | | | | | SHEET 1 / 1
