olokevin/Infrared_Target/红外靶工程图/红外靶开源资料/红外靶工程图及BOM清单/铝架/铝架02.pdf

A

A

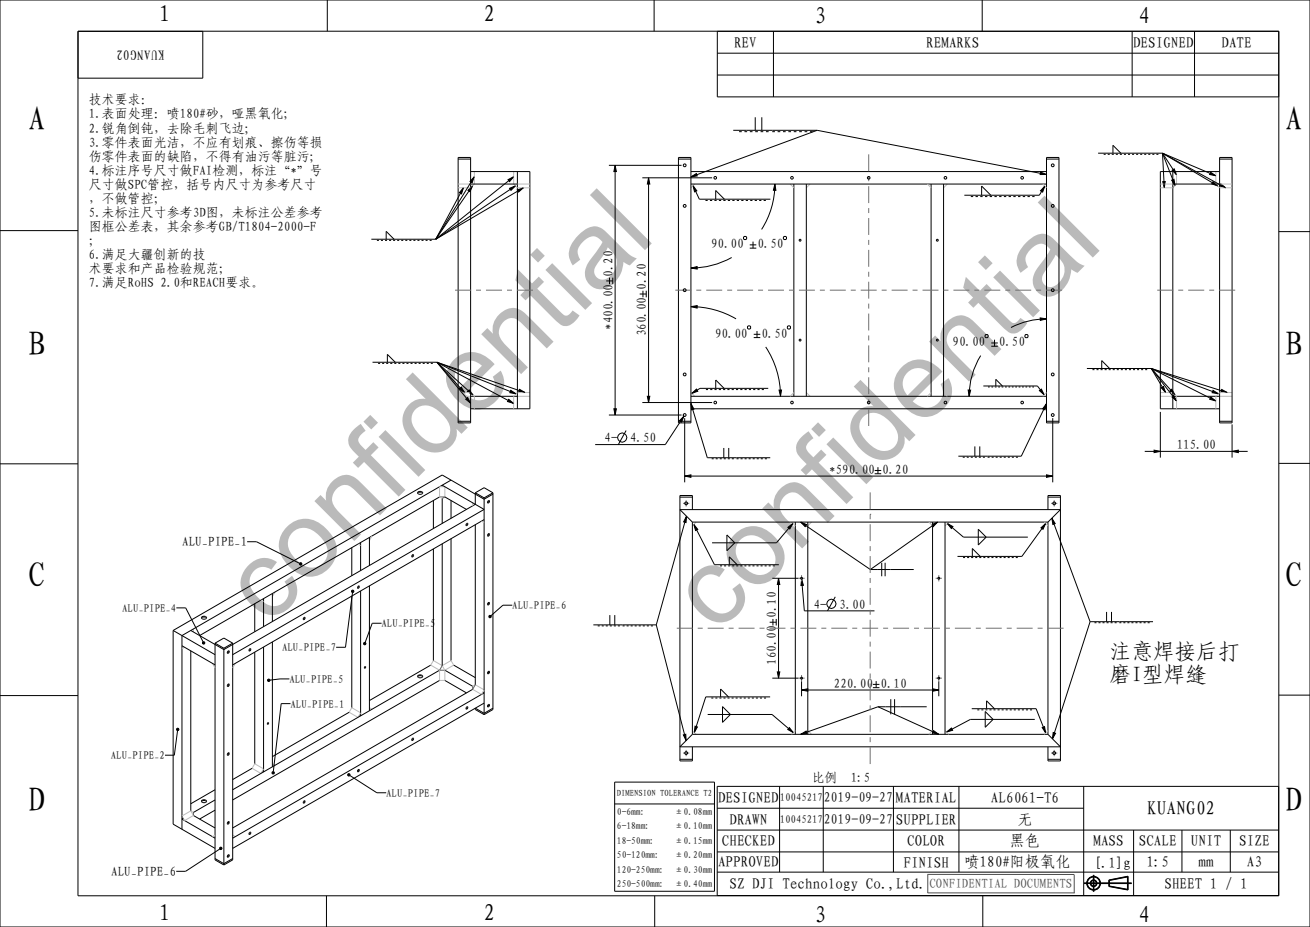
[picture p51: page 1]
confidential confidential *590.00 0.20; 115.00 ³⁶⁰.00 0.20; REV; REMARKS; DESIGNED; DATE; DIMENSION TOLERANCE T2; 技术要求： 1.表面处理：喷180#砂，哑黑氧化; 2.锐角倒钝，去除毛刺飞边; 3.零件表面光洁，不应有划痕、擦伤等损 伤零件表面的缺陷，不得有油污等脏污; 4.标注序号尺寸做FAI检测，标注“*”号 尺寸做SPC管控，括号内尺寸为参考尺寸 ，不做管控； 5.未标注尺寸参考3D图，未标注公差参考 图框公差表，其余参考GB/T1804-2000-F ； 6.满足大疆创新的技 术要求和产品检验规范； 7.满足RoHS 2.0和REACH要求。; 注意焊接后打 磨I型焊缝; ALU_PIPE_7; ALU_PIPE_1; ALU_PIPE_4; ALU_PIPE_2; ALU_PIPE_5; ALU_PIPE_6

DESIGNED100452172019-09-27 MATERIAL | 100452172019-09-27 SUPPLIER | | AL6061-T6 无 | KUANG02 DRAWN

CHECKED | | COLOR | 黑色 | MASS | SCALE | UNIT | SIZE
APPROVED | | FINISH | 喷180#阳极氧化 | [.1]g | 1:5 | mm | A3
SZ DJI Technology Co.,Ltd. | CONFIDENTIAL DOCUMENTS | | | | | SHEET 1 / 1
