olokevin/Infrared_Target/(list of files, drawings)

Other design files:
红外靶硬件设计图T3/红外靶硬件设计图T3/主控板/RM.PP000223.DSN
红外靶硬件设计图T3/红外靶硬件设计图T3/发射板/RM.PP000225.DSN
红外靶硬件设计图T3/红外靶硬件设计图T3/接收板/RM.PP000224.DSN
