olokevin/Infrared_Target/infrared_target-kamin_dev/infrared_target-kamin_dev/Inc/main.h

#define LED_GREEN_Pin GPIO_PIN_14
#define LED_GREEN_GPIO_Port GPIOC
#define LED_RED_Pin GPIO_PIN_15
#define LED_RED_GPIO_Port GPIOC
#define RX2_DATA_Pin GPIO_PIN_10
#define RX2_DATA_GPIO_Port GPIOB
#define RX2_CLK_Pin GPIO_PIN_11
#define RX2_CLK_GPIO_Port GPIOB
#define TX2_CLK_Pin GPIO_PIN_4
#define TX2_CLK_GPIO_Port GPIOB
#define TX2_DATA_Pin GPIO_PIN_5
#define TX2_DATA_GPIO_Port GPIOB
#define TX1_CLK_Pin GPIO_PIN_6
#define TX1_CLK_GPIO_Port GPIOB
#define TX1_DATA_Pin GPIO_PIN_7
#define TX1_DATA_GPIO_Port GPIOB
#define RX1_CLK_Pin GPIO_PIN_8
#define RX1_CLK_GPIO_Port GPIOB
#define RX1_DATA_Pin GPIO_PIN_9
#define RX1_DATA_GPIO_Port GPIOB
