olokevin/Infrared_Target/infrared_target-kamin_dev/infrared_target-kamin_dev/Inc/bsp_flash.h

/**
* @file     bsp_flash.h
* @brief    flash function implement file
* @author   sky
* @date     2015-10-23
* @version  1.0
* @license  Copyright(c) 2015 DJI Corporation Robomasters Department.
*/


#ifndef __BSP_FLASH_H
#define __BSP_FLASH_H


/*
*********************************************************************************************************
*                                             INCLUDE FILES
*********************************************************************************************************
*/


#include "stm32f3xx_hal.h"


/*
*********************************************************************************************************
*                                             FLASH地址定义
*********************************************************************************************************
*/

#define FLASH_PAGE_SIZE     0x800                                               //flash page 2Kbyte  STM32F303CB
#define FLASH_MAX_SIZE      0x40000                                             //the size of flash is 256kb
#define FLASH_MAX_PAGE      0x40                                                //the page of flash is 128


/* FLASH起始地址 */
#define FLASH_ADDR_START        			(0x08000000)
/* FLASH末尾地址 */
#define FLASH_ADDR_END          			(0x080FFFFF)


/* Exported types ------------------------------------------------------------*/
/* Exported constants --------------------------------------------------------*/
/* Exported macro ------------------------------------------------------------*/
/* Base address of the Flash sectors */

#define ADDR_FLASH_PAGE_0     ((uint32_t)0x08000000) /* Base @ of Page 0, 2 Kbytes */
#define ADDR_FLASH_PAGE_1     ((uint32_t)0x08000800) /* Base @ of Page 1, 2 Kbytes */
#define ADDR_FLASH_PAGE_2     ((uint32_t)0x08001000) /* Base @ of Page 2, 2 Kbytes */
#define ADDR_FLASH_PAGE_3     ((uint32_t)0x08001800) /* Base @ of Page 3, 2 Kbytes */
#define ADDR_FLASH_PAGE_4     ((uint32_t)0x08002000) /* Base @ of Page 4, 2 Kbytes */
#define ADDR_FLASH_PAGE_5     ((uint32_t)0x08002800) /* Base @ of Page 5, 2 Kbytes */
#define ADDR_FLASH_PAGE_6     ((uint32_t)0x08003000) /* Base @ of Page 6, 2 Kbytes */
#define ADDR_FLASH_PAGE_7     ((uint32_t)0x08003800) /* Base @ of Page 7, 2 Kbytes */
#define ADDR_FLASH_PAGE_8     ((uint32_t)0x08004000) /* Base @ of Page 8, 2 Kbytes */
#define ADDR_FLASH_PAGE_9     ((uint32_t)0x08004800) /* Base @ of Page 9, 2 Kbytes */
#define ADDR_FLASH_PAGE_10    ((uint32_t)0x08005000) /* Base @ of Page 10, 2 Kbytes */
#define ADDR_FLASH_PAGE_11    ((uint32_t)0x08005800) /* Base @ of Page 11, 2 Kbytes */
#define ADDR_FLASH_PAGE_12    ((uint32_t)0x08006000) /* Base @ of Page 12, 2 Kbytes */
#define ADDR_FLASH_PAGE_13    ((uint32_t)0x08006800) /* Base @ of Page 13, 2 Kbytes */
#define ADDR_FLASH_PAGE_14    ((uint32_t)0x08007000) /* Base @ of Page 14, 2 Kbytes */
#define ADDR_FLASH_PAGE_15    ((uint32_t)0x08007800) /* Base @ of Page 15, 2 Kbytes */
#define ADDR_FLASH_PAGE_16    ((uint32_t)0x08008000) /* Base @ of Page 16, 2 Kbytes */
#define ADDR_FLASH_PAGE_17    ((uint32_t)0x08008800) /* Base @ of Page 17, 2 Kbytes */
#define ADDR_FLASH_PAGE_18    ((uint32_t)0x08009000) /* Base @ of Page 18, 2 Kbytes */
#define ADDR_FLASH_PAGE_19    ((uint32_t)0x08009800) /* Base @ of Page 19, 2 Kbytes */
#define ADDR_FLASH_PAGE_20    ((uint32_t)0x0800A000) /* Base @ of Page 20, 2 Kbytes */
#define ADDR_FLASH_PAGE_21    ((uint32_t)0x0800A800) /* Base @ of Page 21, 2 Kbytes */
#define ADDR_FLASH_PAGE_22    ((uint32_t)0x0800B000) /* Base @ of Page 22, 2 Kbytes */
#define ADDR_FLASH_PAGE_23    ((uint32_t)0x0800B800) /* Base @ of Page 23, 2 Kbytes */
#define ADDR_FLASH_PAGE_24    ((uint32_t)0x0800C000) /* Base @ of Page 24, 2 Kbytes */
#define ADDR_FLASH_PAGE_25    ((uint32_t)0x0800C800) /* Base @ of Page 25, 2 Kbytes */
#define ADDR_FLASH_PAGE_26    ((uint32_t)0x0800D000) /* Base @ of Page 26, 2 Kbytes */
#define ADDR_FLASH_PAGE_27    ((uint32_t)0x0800D800) /* Base @ of Page 27, 2 Kbytes */
#define ADDR_FLASH_PAGE_28    ((uint32_t)0x0800E000) /* Base @ of Page 28, 2 Kbytes */
#define ADDR_FLASH_PAGE_29    ((uint32_t)0x0800E800) /* Base @ of Page 29, 2 Kbytes */
#define ADDR_FLASH_PAGE_30    ((uint32_t)0x0800F000) /* Base @ of Page 30, 2 Kbytes */
#define ADDR_FLASH_PAGE_31    ((uint32_t)0x0800F800) /* Base @ of Page 31, 2 Kbytes */
#define ADDR_FLASH_PAGE_32    ((uint32_t)0x08010000) /* Base @ of Page 32, 2 Kbytes */
#define ADDR_FLASH_PAGE_33    ((uint32_t)0x08010800) /* Base @ of Page 33, 2 Kbytes */
#define ADDR_FLASH_PAGE_34    ((uint32_t)0x08011000) /* Base @ of Page 34, 2 Kbytes */
#define ADDR_FLASH_PAGE_35    ((uint32_t)0x08011800) /* Base @ of Page 35, 2 Kbytes */
#define ADDR_FLASH_PAGE_36    ((uint32_t)0x08012000) /* Base @ of Page 36, 2 Kbytes */
#define ADDR_FLASH_PAGE_37    ((uint32_t)0x08012800) /* Base @ of Page 37, 2 Kbytes */
#define ADDR_FLASH_PAGE_38    ((uint32_t)0x08013000) /* Base @ of Page 38, 2 Kbytes */
#define ADDR_FLASH_PAGE_39    ((uint32_t)0x08013800) /* Base @ of Page 39, 2 Kbytes */
#define ADDR_FLASH_PAGE_40    ((uint32_t)0x08014000) /* Base @ of Page 40, 2 Kbytes */
#define ADDR_FLASH_PAGE_41    ((uint32_t)0x08014800) /* Base @ of Page 41, 2 Kbytes */
#define ADDR_FLASH_PAGE_42    ((uint32_t)0x08015000) /* Base @ of Page 42, 2 Kbytes */
#define ADDR_FLASH_PAGE_43    ((uint32_t)0x08015800) /* Base @ of Page 43, 2 Kbytes */
#define ADDR_FLASH_PAGE_44    ((uint32_t)0x08016000) /* Base @ of Page 44, 2 Kbytes */
#define ADDR_FLASH_PAGE_45    ((uint32_t)0x08016800) /* Base @ of Page 45, 2 Kbytes */
#define ADDR_FLASH_PAGE_46    ((uint32_t)0x08017000) /* Base @ of Page 46, 2 Kbytes */
#define ADDR_FLASH_PAGE_47    ((uint32_t)0x08017800) /* Base @ of Page 47, 2 Kbytes */
#define ADDR_FLASH_PAGE_48    ((uint32_t)0x08018000) /* Base @ of Page 48, 2 Kbytes */
#define ADDR_FLASH_PAGE_49    ((uint32_t)0x08018800) /* Base @ of Page 49, 2 Kbytes */
#define ADDR_FLASH_PAGE_50    ((uint32_t)0x08019000) /* Base @ of Page 50, 2 Kbytes */
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
#define ADDR_FLASH_PAGE_235   ((uint32_t)0x08075800) /* Base @ of Page 235, 2 Kbytes */
#define ADDR_FLASH_PAGE_236   ((uint32_t)0x08076000) /* Base @ of Page 236, 2 Kbytes */
#define ADDR_FLASH_PAGE_237   ((uint32_t)0x08076800) /* Base @ of Page 237, 2 Kbytes */
#define ADDR_FLASH_PAGE_238   ((uint32_t)0x08077000) /* Base @ of Page 238, 2 Kbytes */
#define ADDR_FLASH_PAGE_239   ((uint32_t)0x08077800) /* Base @ of Page 239, 2 Kbytes */
#define ADDR_FLASH_PAGE_240   ((uint32_t)0x08078000) /* Base @ of Page 240, 2 Kbytes */
#define ADDR_FLASH_PAGE_241   ((uint32_t)0x08078800) /* Base @ of Page 241, 2 Kbytes */
#define ADDR_FLASH_PAGE_242   ((uint32_t)0x08079000) /* Base @ of Page 242, 2 Kbytes */
#define ADDR_FLASH_PAGE_243   ((uint32_t)0x08079800) /* Base @ of Page 243, 2 Kbytes */
#define ADDR_FLASH_PAGE_244   ((uint32_t)0x0807a000) /* Base @ of Page 244, 2 Kbytes */
#define ADDR_FLASH_PAGE_245   ((uint32_t)0x0807a800) /* Base @ of Page 245, 2 Kbytes */
#define ADDR_FLASH_PAGE_246   ((uint32_t)0x0807b000) /* Base @ of Page 246, 2 Kbytes */
#define ADDR_FLASH_PAGE_247   ((uint32_t)0x0807b800) /* Base @ of Page 247, 2 Kbytes */
#define ADDR_FLASH_PAGE_248   ((uint32_t)0x0807c000) /* Base @ of Page 248, 2 Kbytes */
#define ADDR_FLASH_PAGE_249   ((uint32_t)0x0807c800) /* Base @ of Page 249, 2 Kbytes */
#define ADDR_FLASH_PAGE_250   ((uint32_t)0x0807d000) /* Base @ of Page 250, 2 Kbytes */
#define ADDR_FLASH_PAGE_251   ((uint32_t)0x0807d800) /* Base @ of Page 251, 2 Kbytes */
#define ADDR_FLASH_PAGE_252   ((uint32_t)0x0807e000) /* Base @ of Page 252, 2 Kbytes */
#define ADDR_FLASH_PAGE_253   ((uint32_t)0x0807e800) /* Base @ of Page 253, 2 Kbytes */
#define ADDR_FLASH_PAGE_254   ((uint32_t)0x0807f000) /* Base @ of Page 254, 2 Kbytes */
#define ADDR_FLASH_PAGE_255   ((uint32_t)0x0807f800) /* Base @ of Page 255, 2 Kbytes */




/*
*********************************************************************************************************
*                                      FUNCTION PROTOTYPES
*********************************************************************************************************
*/
uint16_t bsp_flash_get_sector(uint32_t addr);							        //获取指定地址所在flash的块首地址
void bsp_flash_read(uint32_t ReadAddr, uint8_t *pBuffer, uint32_t NumToRead);   //从指定地址开始读出指定长度的数据

void bsp_flash_clear_flag(void);
int bsp_flash_erase(uint32_t addr, uint32_t len);
int bsp_flash_write_bytes(uint32_t addr, void *p_data, uint32_t byte_num);  
int bsp_flash_write_words(uint32_t addr, void *p_data, uint32_t wordNum);


#endif
