olokevin/Infrared_Target/infrared_target-kamin_dev/infrared_target-kamin_dev/Inc/Logic.h

#ifndef __LOGIC_H
#define __LOGIC_H

#include "gpio.h"
#include "main.h"

typedef struct
{
	GPIO_TypeDef *GPIOx;
	uint32_t GPIO_Pin;
}GPIO_Function;


typedef struct
{
	GPIO_Function Data;
	GPIO_Function CLK;
}HC164_GPIO;


void IR_PT_SysInit(void);

#endif
