olokevin/Infrared_Target/(notices)

Notices in the files:
infrared_target-kamin_dev/infrared_target-kamin_dev/Inc/main.h:
© Copyright (c) 2019 STMicroelectronics.
All rights reserved.
This software component is licensed by ST under Ultimate Liberty license
(C) COPYRIGHT STMicroelectronics *****END OF FILE
